energee/neo/giraffe/honda/clarity/README.md

Honda Clarity Giraffe
====

Get your panda deeper into your Clarity

The switches
====

The 4 DIP switches control signals to the stock ADAS system

- 1 -- ADAS F-CAN_A -> panda CAN1

- 2 -- ADAS RADAR-CAN -> panda CAN2 (OBDII pins 12 & 13)

- 3 -- ADAS F-CAN_B -> panda CAN3

- 4 -- ADAS power & ignition -> power & ignition
