energee/neo/giraffe/honda/clarity/giraffe_clarity.brd

## EAGLE design giraffe/honda/clarity/giraffe_clarity.brd (2018-10-30)

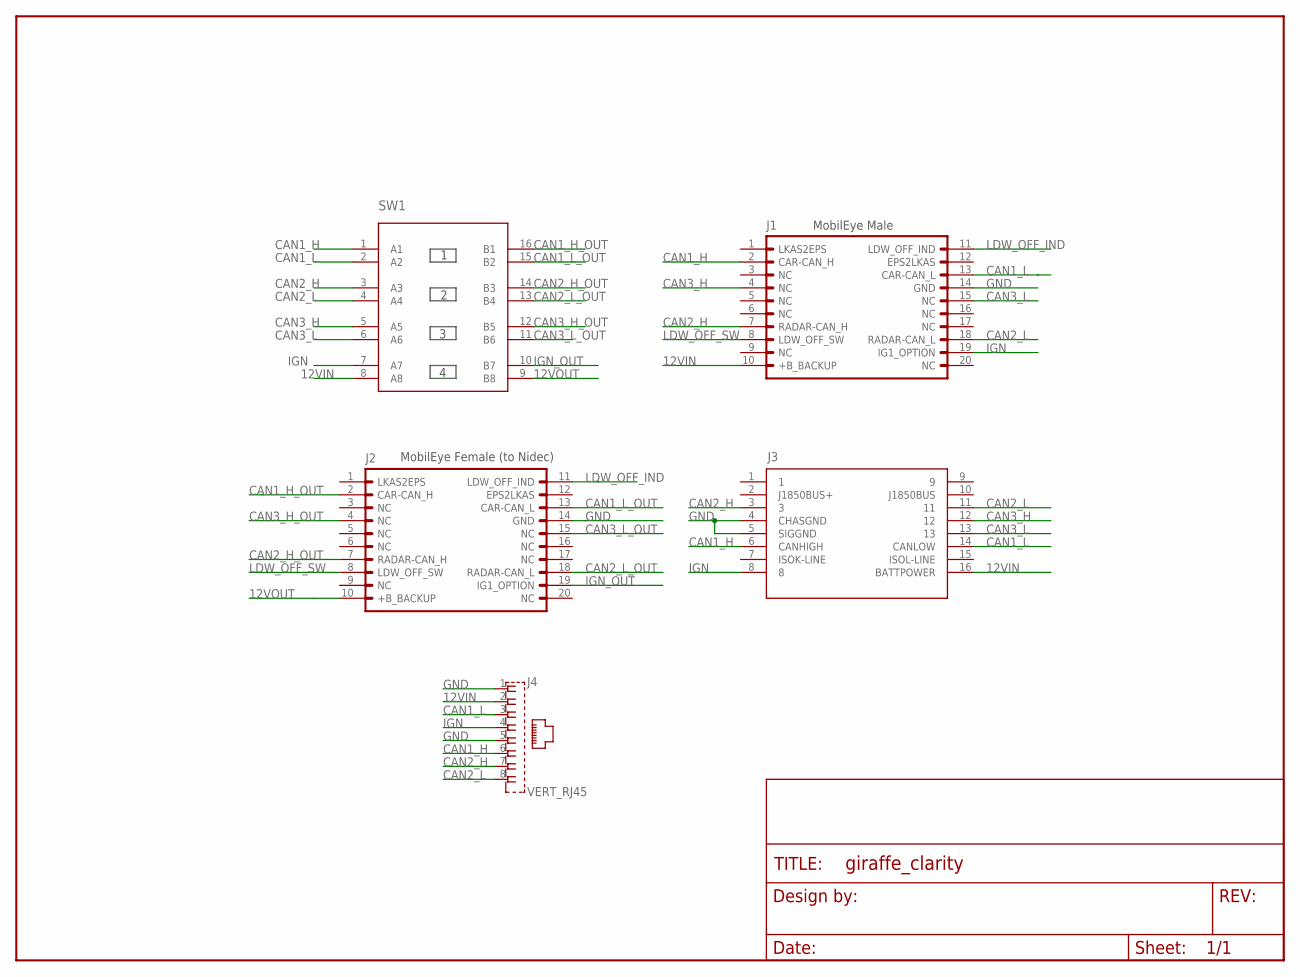
[picture p1: schematic giraffe_clarity.sch]

Parts:
FRAME1: FRAME-LETTERNO_PACKAGE; DUMMY
J1: MOBILEYERAMALE; 2X10(RA)
J2: MOBILEYEFEMALE; 2X10(JAE_FEMALE)
J3: OBDII-FEMALE-CUT; OBDII-FEMALE-MIDCUT
J4: VERT_RJ45; GLX-S-88M
SW1: 4XDPSTSMT; 4-DPST

Connections:
12VIN: J1.10 (+B_BACKUP), J3.16 (BATTPOWER), J4.2, SW1.8 (A8)
12VOUT: J2.10 (+B_BACKUP), SW1.9 (B8)
CAN1_H: J1.2 (CAR-CAN_H), J3.6 (CANHIGH), J4.6, SW1.1 (A1)
CAN1_H_OUT: J2.2 (CAR-CAN_H), SW1.16 (B1)
CAN1_L: J1.13 (CAR-CAN_L), J3.14 (CANLOW), J4.3, SW1.2 (A2)
CAN1_L_OUT: J2.13 (CAR-CAN_L), SW1.15 (B2)
CAN2_H: J1.7 (RADAR-CAN_H), J3.3, J4.7, SW1.3 (A3)
CAN2_H_OUT: J2.7 (RADAR-CAN_H), SW1.14 (B3)
CAN2_L: J1.18 (RADAR-CAN_L), J3.11, J4.8, SW1.4 (A4)
CAN2_L_OUT: J2.18 (RADAR-CAN_L), SW1.13 (B4)
CAN3_H: J1.4 (NC), J3.12, SW1.5 (A5)
CAN3_H_OUT: J2.4 (NC), SW1.12 (B5)
CAN3_L: J1.15 (NC), J3.13, SW1.6 (A6)
CAN3_L_OUT: J2.15 (NC), SW1.11 (B6)
GND: J1.14 (GND), J2.14 (GND), J3.4 (CHASGND), J3.5 (SIGGND), J4.1, J4.5
IGN: J1.19 (IG1_OPTION), J3.8, J4.4, SW1.7 (A7)
IGN_OUT: J2.19 (IG1_OPTION), SW1.10 (B7)
LDW_OFF_IND: J1.11 (LDW_OFF_IND), J2.11 (LDW_OFF_IND)
LDW_OFF_SW: J1.8 (LDW_OFF_SW), J2.8 (LDW_OFF_SW)

Notes on the sheet:
MobilEye Male
MobilEye Female (to Nidec)

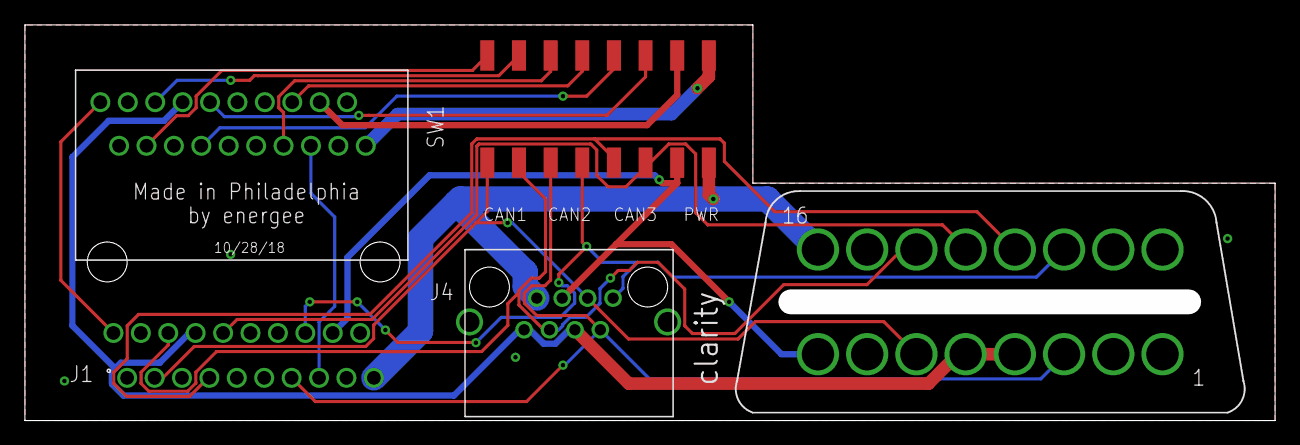
[picture p2: board giraffe_clarity.brd from above]

Board: 2 copper layers, 100.3 x 31.8 mm, 6 parts (1 on the bottom side), 19 nets.
