energee/neo/(commit log)

2018-10-26 Add Odyssey giraffe
    [BOM.csv, case.stl, giraffe20_flipped.brd, giraffe20_flipped.sch]
2018-10-28 Add Clarity board
    [giraffe_clarity.brd, giraffe_clarity.sch]
2018-10-28 Update flipped board
    [giraffe20_flipped.brd, giraffe20_flipped.sch]
2018-10-28 Remove inverted giraffe and add clarity docs
    [BOM.csv, case.stl, giraffe20_flipped.brd, giraffe20_flipped.sch]
2018-10-28 Added minor tweaks
    [giraffe_clarity.brd]
2018-10-28 Moved silkscreens
    [giraffe20_flipped.brd]
2018-10-28 Fixed ground vias
    [giraffe20_flipped.brd, giraffe_clarity.brd]
2018-10-30 Updated both board traces
    [giraffe20_flipped.brd, giraffe_clarity.brd]
